alvaroaltvis/DeepSoRo_SoftFinger/CAD_soft_robot/Soft Finger Holder Revised.STL

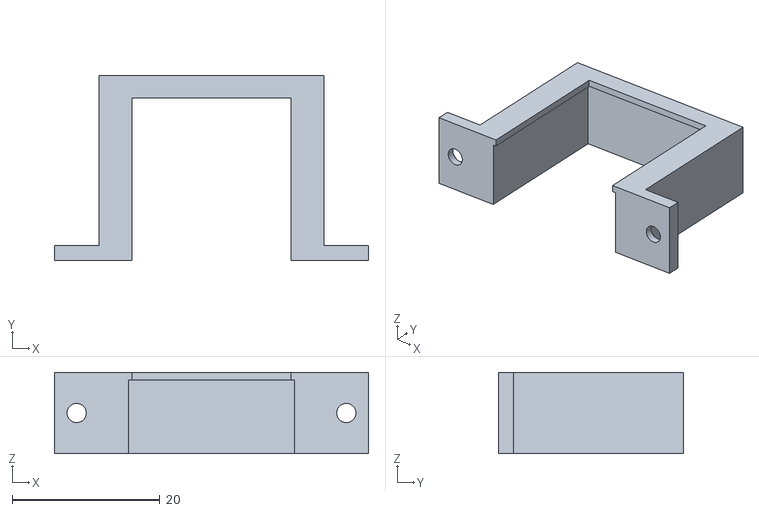
[picture p1: CAD file, 2022-07-26]
CAD_soft_robot/Soft Finger Holder Revised.STL
42.5 x 25.0 x 11.0
