alvaroaltvis/DeepSoRo_SoftFinger/CAD_soft_robot/Outside Mold Revised.STL

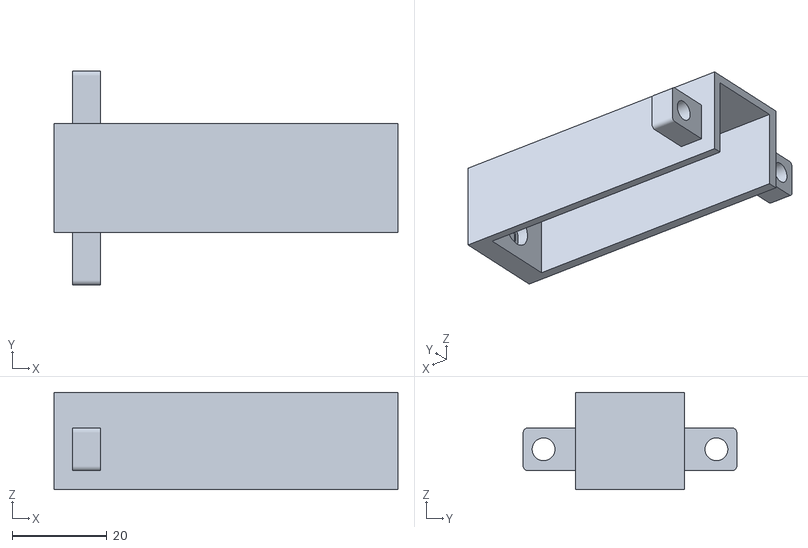
[picture p2: CAD file, 2022-07-26]
CAD_soft_robot/Outside Mold Revised.STL
72.5 x 45.0 x 20.5
