alvaroaltvis/DeepSoRo_SoftFinger/CAD_soft_robot/Camera Mount Reviesd.STL

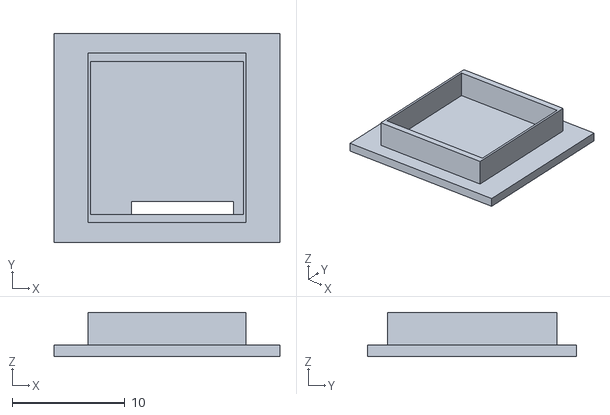
[picture p3: CAD file, 2022-07-26]
CAD_soft_robot/Camera Mount Reviesd.STL
20.0 x 18.5 x 3.90
