alvaroaltvis/DeepSoRo_SoftFinger/CAD_soft_robot/Base of the finger Revised.STL

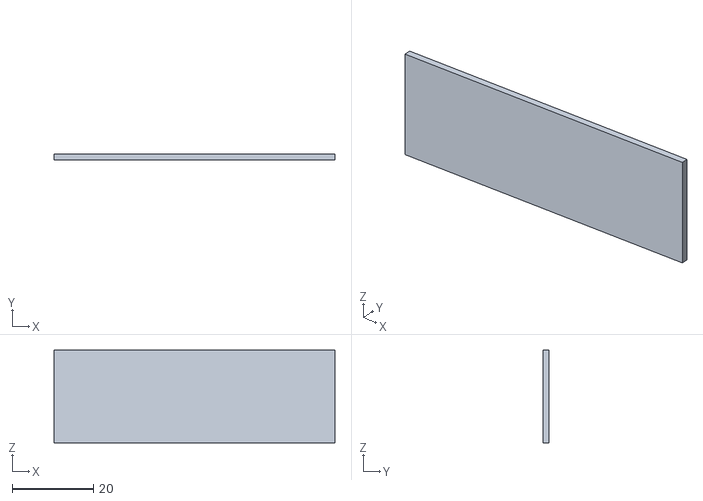
[picture p4: CAD file, 2022-07-26]
CAD_soft_robot/Base of the finger Revised.STL
69.0 x 1.50 x 22.8
