alvaroaltvis/DeepSoRo_SoftFinger/(commit log)

2022-07-11 Silicon Body For Soft Robot Finger
    [Silicon Body.SLDPRT]
2022-07-11 Soft Robot FInger
    [Silicon Body.SLDPRT]
2022-07-25 Update and rename pwm_remote.py to pwm_remotepause.py
